philippedc/Arduino-DC-12-24V-to-AC-230V-380V-3-phases-inverter/3phases-inverter_test.jpg

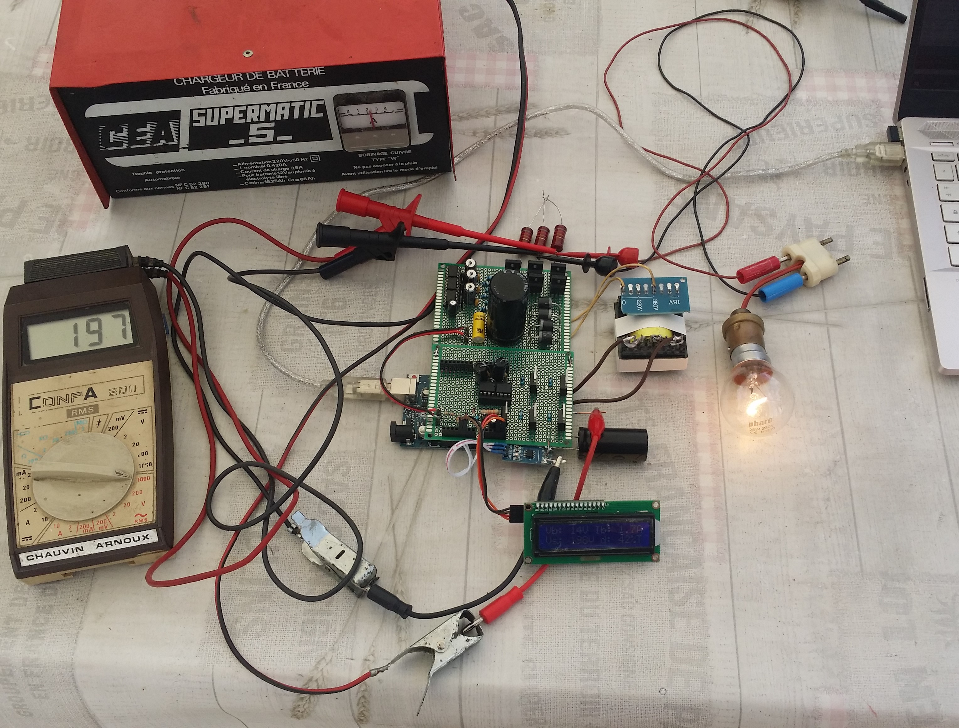
3phases-inverter_test.jpg
