philippedc/Arduino-DC-12-24V-to-AC-230V-380V-3-phases-inverter/README.md

# Arduino-DC-12-24V-to-AC-230V-380V-3-phases-inverter
This study is an exemple how to build a 3-phases 230V/380V from a 12-24V DC with an Arduino Uno
